DH-1279/microprocessor-capstone-design/03. 김가네 캡스톤 디자인/docs/2026-10-16_DH_AI_HAT_카메라_추론_및_쿨러_동작점검.md

# AI HAT+ 2·카메라 실제 추론 및 액티브 쿨러 동작 점검

- 작업일: 2026-10-16
- 담당: 김동환(DH)
- 대상: Raspberry Pi 5, AI HAT+ 2(Hailo-10H), Camera Module 3, 액티브 쿨러
- 작업 브랜치: `DH-1279/2026-10-16`
- 확인 근거: 사용자가 전달한 Pi 터미널 로그·실물 동작 확인, 공통 추론 코드 및 수정 후 개발 PC 검사 결과

**해수가 업로드한 18클래스 HEF 모델을 공통 `haptic_mvp` 코드로 실행하여, 실제 카메라 영상에서 탐지 이름·신뢰도·좌표가 출력되는 것을 확인했다. 액티브 쿨러는 10초 최대 출력 시험과 사용자 확인으로 회전 동작을 점검했다.**

이번 시험은 카메라와 HAT의 단독 추론이다. 손 인식, 음성 명령, 목표 선택, BLE 모터 제어를 연결한 전체 MVP 시험은 아직 수행하지 않았다.

## 1. 실행 환경과 모델

| 항목 | 확인 내용 |
|---|---|
| 운영체제·아키텍처 | Debian GNU/Linux 13 Trixie, `aarch64` |
| Pi Python | 3.13.5, 기존 `Raspi5_vision/.venv` 사용 |
| HailoRT CLI·펌웨어 | 5.1.1 |
| 장치 | AI HAT+ 2, `HAILO10H` |
| 카메라 | IMX708, Camera Module 3 |
| 카메라 출력 | 640×480. 로그의 libcamera 스트림 표기는 `BGR888` |
| 모델 입력 | RGB, UINT8, NHWC, 640×640×3 |
| 모델 출력 | FLOAT32, `HAILO NMS BY CLASS`, 18클래스 |
| HEF 내 후처리 설정 | score threshold 0.250, IoU threshold 0.70, 클래스당 최대 100박스 |
| 공통 코드의 점수 필터 | 기본 `score_threshold: 0.5` 적용 |
| 시험 도구 | [`tools/check_hailo_camera.py`](../Raspi5_vision/tools/check_hailo_camera.py) |

### 시험에 사용한 모델 출처

- 팀원 브랜치: `seawater0414/2026-10-14`
- 검토 기준 커밋: `d96d859621cf353c0c9aca11e521626319d2a93a`
- 저장소 내 모델: `03. 김가네 캡스톤 디자인/Raspi5_vision/KHS_object_detection/best_hailo_model/best.hef`
- Pi 시험용 모델: `/tmp/kimgane-khs-check/best.hef`
- Pi 시험용 라벨: `/tmp/kimgane-khs-check/labels.txt`
- 검토한 HEF의 SHA-256: `3e78431a361cb154617472d7ea133e428c17aecd23ea95e929e874206667e788`

라벨은 학습 때의 클래스 번호에 맞춰 다음 순서를 사용했다. 대소문자도 유지했다.

```text
bottle, cell phone, cup, handbag, keyboard, laptop,
mouse, remote, scissors, tie, Glasses, key,
Medicine, Tumbler, Pen, Wallet, watch, Wireless Earbud
```

`parse-hef`는 `HEF Compatible for: HAILO15H, HAILO10H`와 18클래스 NMS 출력을 표시했다. 이후 실제 장치에서 모델 로딩과 추론까지 성공했다. HEF에 기록된 컴파일 SDK 버전은 5.4.0이지만, 이번 파일은 설치된 HailoRT 5.1.1에서 실행됐다. 이 결과를 다른 HEF 파일의 호환성 보장으로 확대하지 않는다.

## 2. 실행 중 발생한 오류와 수정

| 발생한 문제 | 확인 내용·원인 | 조치와 결과 |
|---|---|---|
| `FileNotFoundError: .../labels.txt` | 라벨을 기록하려는 `/tmp/kimgane-khs-check` 폴더가 없었음. 폴더가 없어진 이유는 확정하지 않음 | 폴더를 생성하고 HEF·라벨을 다시 준비 |
| `AttributeError: 'Device' object has no attribute 'identify'` | 코드가 설치된 HailoRT Python API와 다른 호출 경로를 사용 | `physical.control.identify()`로 수정. 이후 모델 로딩 성공 |
| `ValueError: Expected normalized, ordered NMS coordinates` | 기존 검사는 모든 NMS 좌표가 0~1 안에 있어야 한다고 가정. Hailo YOLOv8 디코더는 경계 밖 좌표를 출력할 수 있음을 공식 구현에서 확인 | Hailo NMS 경로에서 경계 밖 좌표를 허용하고 원본 영상 범위로 잘라내도록 수정. 이후 152프레임 실행에서 재발 없음 |
| 기본 10프레임으로 관찰 시간이 짧음 | 물체를 카메라에 보여주며 확인하기에는 실행 시간이 짧았음 | `--frames 300`으로 늘리고 외부 제한을 `timeout 180s`로 설정 |

좌표 오류 당시의 원시 NMS 행은 확보하지 못했으므로, 정확히 어떤 값이 예외를 일으켰는지는 확정하지 않았다. 수정은 공식 디코더의 경계 처리 방식과 코드의 과도한 범위 제한을 근거로 진행했다.

수정 후에도 NaN·무한대, 뒤집힌 좌표, 잘못된 클래스 수·출력 형식은 오류로 처리한다. 영상과 겹치지 않거나 면적이 없는 박스는 제외한다. 좌표 복원 함수의 다른 호출 경로에는 기존의 엄격한 범위 검사를 유지했다.

### 반영한 코드

- `fef8cc6` — `fix: identify Hailo devices through Control API`
  - 장치 식별 API와 doctor 검사, 관련 테스트 및 설치 안내 수정.
- `d5d65fb` — `fix: clip Hailo edge detections to the source frame`
  - NMS 경계 좌표 복원 수정, 회귀 테스트 추가, 카메라·HAT 단독 시험 도구 추가.

실제 Pi 시험은 위 수정 사항이 있는 `DH-1279/2026-10-16` 브랜치를 받아 진행했다. 이 문서는 해당 브랜치가 `main`에 머지됐다는 기록은 아니다.

## 3. 카메라·HAT 실제 추론 결과

### 실행 명령

모델과 라벨을 준비하고 수정 브랜치를 받은 상태에서 다음 명령으로 실행했다.

```bash
cd "$HOME/Desktop/kimGA_raspi/microprocessor-capstone-design/03. 김가네 캡스톤 디자인/Raspi5_vision"
source .venv/bin/activate
timeout 180s python -u tools/check_hailo_camera.py --frames 300
```

PuTTY에서 실행했으며, 별도의 영상 창 없이 터미널에 탐지 결과를 출력했다. 시험 도구는 프레임마다 0.3초씩 대기한다.

### 로그 집계

| 항목 | 결과 |
|---|---:|
| 요청한 프레임 | 300 |
| 실제 출력된 프레임 | 152 |
| 첫 프레임 탐지 함수 처리 시간 | 57.2ms |
| 2~152프레임 평균 처리 시간 | 약 13.6ms |
| 2~152프레임 처리 시간 범위 | 13.2~14.0ms |
| 탐지 결과가 있는 프레임 | 91 |
| 탐지 결과가 없는 프레임 | 61 |
| 프레임 전체에서 출력한 탐지 항목 수 | 115 |
| 출력된 신뢰도 범위 | 0.50~0.82 |
| 종료 | 152프레임 후 사용자가 `Ctrl+C`로 중단 |
| 최종 실행의 Python 예외 | 없음 |

| 출력된 라벨 | 프레임 전체의 출력 횟수 |
|---|---:|
| `watch` | 17 |
| `cell phone` | 5 |
| `Glasses` | 45 |
| `mouse` | 4 |
| `keyboard` | 44 |

115개는 같은 물체를 여러 프레임에서 탐지한 항목을 포함한다. 서로 다른 실물 115개를 인식했다는 의미가 아니다. 또한 91/152는 정확도나 재현율이 아니다. 실제 화면의 정답과 비교하지 않았으므로 모델 성능 수치로 사용하지 않는다.

### 대표 출력

```text
모델 로딩 성공 | 입력 640×640 | 클래스 18개
프레임 11/300 | 추론 13.6ms | 탐지 2개
  watch | 신뢰도 0.67 | 좌표 (0.028, 0.054, 0.913, 0.208)
  cell phone | 신뢰도 0.56 | 좌표 (0.796, 0.129, 1.0, 0.857)
...
프레임 152/300 | 추론 13.5ms | 탐지 0개
^C
사용자 요청으로 점검을 중단했습니다.
```

출력 좌표는 원본 영상 기준의 정규화된 `(x1, y1, x2, y2)`다. 영상 가장자리를 넘어가는 박스는 0~1 범위로 잘리므로 `1.0` 같은 경계값이 나올 수 있다. 값이 출력된 사실만으로 실제 물체와 박스가 정확히 일치한다고 판단하지 않는다.

처리 시간은 `detector.detect(rgb)` 호출에 소요된 시간으로, 전처리·HAT 실행·결과 해석을 포함한다. 카메라 읽기, 터미널 출력, 프레임 사이 대기는 포함하지 않는다. 따라서 **약 13.6ms를 전체 시스템의 70FPS 이상 처리 성능이나 종단 간 응답 시간으로 해석하지 않는다.**

카메라 초기화 때 `Unsupported V4L2 pixel format Nc30`, `Nc12` 경고가 있었지만, 이어서 스트림 설정과 추론이 진행됐다. 이번 로그에서는 실행을 중단시킨 오류가 아니었다.

## 4. 액티브 쿨러 설치 및 시험

액티브 쿨러 설치 후 온도 설정과 회전 센서값을 확인했다.

```bash
grep -H . /sys/class/thermal/thermal_zone0/trip_point_*_temp
grep -H . /sys/class/hwmon/hwmon*/fan1_input 2>/dev/null
```

| 조회 항목 | 실제 출력 |
|---|---|
| `trip_point_0_temp` | 110000 |
| `trip_point_1_temp` | 50000 |
| `trip_point_2_temp` | 60000 |
| `trip_point_3_temp` | 67500 |
| `trip_point_4_temp` | 75000 |
| 팬 장치 이름 | `pwmfan` |
| 최초 회전수 출력 | 2623 RPM |
| 이후 모니터 화면 | CPU 49.6°C, 팬 2726 RPM |

`trip_point_0`의 110°C는 팬 시작 온도로 해석하지 않는다. 또한 센서값만으로 사용자가 보고한 “팬이 안 도는 것 같다”는 관찰을 해소했다고 판단하지 않고, 최대 출력 시험을 추가했다.

### 10초 최대 출력 시험

시험 스크립트는 PWM을 최대값으로 유지하며 매초 회전수를 출력하고, 종료 시 이전 PWM 값으로 복원하도록 실행했다. 실제 출력은 다음과 같다.

```text
1초  7867 RPM
2초  8736 RPM
3초  8849 RPM
4초  8865 RPM
5초  8891 RPM
6초  8925 RPM
7초  8965 RPM
8초  9003 RPM
9초  9038 RPM
10초 9077 RPM
테스트 전 PWM 값(0)으로 복구했습니다.
```

사용자가 최대 출력 때 팬 소리·바람이 강해졌음을 확인했다. 이 결과로 팬 회전과 속도 변경 동작을 확인했다. 이번 추론 시험 중의 CPU·Hailo 온도 로그는 수집하지 않았으므로, 쿨러 설치 전후의 냉각 성능이나 장시간 추론 시 온도 안정성은 아직 비교하지 않았다.

## 5. 개발 PC에서 수행한 코드 검사

최종 좌표 수정 후 개발 PC에서 수행한 검사 결과다. 실제 Pi 하드웨어 시험과 별도로 구분한다.

| 검사 | 결과 | 확인 범위 |
|---|---|---|
| pytest | 946 passed, 47 subtests passed | 공통 로직 및 SDK 대역을 이용한 회귀 검사 |
| 시뮬레이션 | 6개 시나리오 PASS | 손·목표 유실, 오래된 프레임, 다중 물체, 통신 유실 등 제어 시나리오 |
| Ruff | 통과 | 정적 코드 검사 |
| Mypy | 통과 | 타입 검사 |
| 시험 도구 CLI | 도움말·모델 누락 시 초기 오류 확인 | 실행 옵션과 파일 준비 조건 |

이번에 추가한 테스트는 장치 식별 API와 자원 해제, 경계 밖 NMS 좌표, 원본 영상 좌표 복원, 잘못된 좌표 거부를 다뤘다. 이러한 검사가 실제 카메라 인식 정확도나 물리적 모터 동작을 검증한 것은 아니다.

## 6. 현재 완료 상태와 다음 작업

- [x] AI HAT+ 2 장치 식별 및 HEF 출력 계약 확인.
- [x] 해수의 18클래스 HEF를 실제 HAT에 로딩.
- [x] 실제 카메라 입력으로 물체 이름·신뢰도·좌표 출력.
- [x] API 호출 오류 수정 후 실제 실행 확인.
- [x] NMS 좌표 경계 처리 수정 후 152프레임 실행 확인.
- [x] 액티브 쿨러 최대 출력 시험 및 사용자 동작 확인.
- [ ] 박스·라벨을 영상에 표시하여 실제 물체와 비교.
- [ ] 고정된 카메라 위치에서 대상 물체별 오탐·미탐·가림·거리 변화 기록.
- [ ] 더 긴 연속 추론과 CPU·Hailo 온도·전체 처리 속도 측정.
- [ ] MediaPipe 손 모델 준비 및 같은 영상 프레임에서 손·물체 좌표 확인.
- [ ] 18클래스 라벨과 한국어 음성 명령·목표 목록의 매핑 정리.
- [ ] 목표 선택·손 방향 계산·BLE·모터 출력 연결.

우선 다음 시험은 **PC 브라우저 등에서 박스와 이름이 표시된 영상을 보며 탐지를 확인하는 것**이 적절하다. 현재 텍스트 로그는 추론 경로의 동작을 보여주지만, 올바른 물체를 올바른 위치에서 잡는지는 보여주지 못한다. 영상 확인 방식은 아직 구현·시험하지 않았다.

전체 MVP 설정에는 별도 확인이 필요하다. 이번 시험은 임시 HEF·18라벨을 시험 도구에만 지정했으며 기본 모델 파일이나 공통 설정을 교체하지 않았다. 기존 목표 목록의 `book`은 이번 18클래스에 없으므로 통합 전에 목표 목록도 함께 조정해야 한다.

해수의 **모델 파일 실행 성공**과 해수 브랜치의 **GStreamer 실행 코드 전체 검증**은 구분한다. 이번에는 공통 `HailoDetector`를 사용했으므로 팀원 코드의 API·콜백·라벨 형식 문제를 해결했다거나, 팀원 브랜치 전체가 머지 가능한 상태라고 판단하지 않는다. 기존 수정 요청은 [팀원 코드 리뷰 문서](2026-10-15_DH_팀원코드리뷰_및_실행점검.md)와 함께 확인한다.

## 7. 서멀 모니터 개선

액티브 쿨러 설치에 맞춰 [`thermal_monitor.py`](../Raspi5_vision/tools/thermal_monitor.py)를 개선했다.

- CPU 온도 옆에 팬 상태와 RPM 표시. 좁은 터미널에서는 팬을 별도 행으로 표시.
- `RUNNING`, `STOPPED`, PWM 출력 중 회전수 0인 `CHECK`, 조회 실패 `N/A`를 구분.
- 팬 장치 이름으로 센서를 찾으므로 `hwmon` 번호가 바뀌어도 조회 가능.
- 화면 크기에 맞춰 각 행을 고정 위치에 갱신. 화면 아래쪽·오른쪽 끝 출력과 새 줄 누적을 피하도록 변경.
- 별도 터미널 화면에서 실행하고 종료 시 원래 화면·커서를 복원.
- 팬 제어 파일에 값을 쓰지 않으며, 기존 자동 팬 제어를 유지.
- 터미널이 아닌 출력은 기본 한 번만 표시. 반복 파일 기록은 `--log`로 명시.

Pi에서 새 코드를 받은 뒤, 별도 PuTTY 터미널에서 실행할 명령은 다음과 같다. `watch`로 감싸지 않는다.

```bash
cd "$HOME/Desktop/kimGA_raspi/microprocessor-capstone-design/03. 김가네 캡스톤 디자인/Raspi5_vision"
python3 tools/thermal_monitor.py --screen
```

화면 예시의 숫자는 가상값이다. 실제 센서 결과와 혼동하지 않도록 `--demo` 실행에는 `SIMULATED`를 표시한다.

```text
CPU    46.5 °C  █████████░░░░░░░░░░░  |  FAN RUNNING 2726 RPM
HAILO  54.2 °C  ███████████░░░░░░░░░
```

개발 PC에서 관련 테스트 **21개와 subtest 23개**, Ruff·Mypy 검사를 통과했다. 팬 장치 탐색, 센서 실패·정지 구분, 화면 크기 변경·한글 폭 처리, 갱신 시 새 줄 미출력, 예외·Ctrl+C 종료 복원을 확인했다. **개선한 모니터의 실제 Pi·PuTTY 실행은 아직 미확인**이며, 앞 절의 실제 팬 시험과 구분한다. 센서 조회 근거는 [Linux pwm-fan 문서](https://docs.kernel.org/hwmon/pwm-fan.html)를 참고한다.

## 8. 재실행 시 주의 사항과 관련 자료

`/tmp/kimgane-khs-check`의 모델·라벨은 임시 파일이다. 재부팅 등으로 사라지면 다시 준비해야 한다. 시험 도구는 파일이 없거나 비어 있으면 시작 전에 오류를 내며, 모델을 자동 다운로드하지 않는다. 다른 위치의 준비된 파일은 `--model`, `--labels`로 지정할 수 있다.

300프레임과 180초는 실행 제한이다. 이번에는 사용자가 먼저 종료했으므로 300프레임 완주나 180초 연속 동작을 확인한 것으로 기록하지 않는다.

- [공통 비전 설치·실행 안내](../Raspi5_vision/VISION_SETUP.md)
- [카메라·HAT 단독 시험 도구](../Raspi5_vision/tools/check_hailo_camera.py)
- [USB 마이크·스피커 기본 시험 기록 — 2026-10-15](2026-10-15_DH_USB_마이크_스피커_동작점검.md)
- [HailoRT 5.1.1 공식 Python API](https://github.com/hailo-ai/hailort/blob/v5.1.1/hailort/libhailort/bindings/python/platform/hailo_platform/pyhailort/pyhailort.py): 장치 식별 호출 경로 확인 근거.
- [HailoRT 5.1.1 공식 YOLOv8 후처리 구현](https://github.com/hailo-ai/hailort/blob/v5.1.1/hailort/libhailort/src/net_flow/ops/yolov8_post_process.cpp): 경계 밖 좌표가 생성될 수 있는 디코딩 방식 확인 근거.
