DH-1279/microprocessor-capstone-design/03. 김가네 캡스톤 디자인/docs/2026-09-29_역할분담_회의록.md

# 역할 분담 회의록

- 회의일: 2026-09-29
- 상태: 세부 역할 분담 확정
- 작성 근거: 회의 논의 내용과 사전 공유된 파트 구분안

## 1. 파트 구분

사전에 공유된 파트는 다음 네 가지다.

| 번호 | 파트 | 내용 |
|---|---|---|
| 1 | 핸드 인식 | MediaPipe 기반 손 인식 |
| 2 | 물체 인식 | YOLO + COCO 데이터셋 기반 인식. Kaggle·HuggingFace 등에서 데이터셋 추가 조사. 라즈베리파이에서 구동 가능한 경량 모델 선정 |
| 3 | 회로 | PCB 및 ESP32 메모리 최적화 |
| 4 | 프론트 | 라즈베리파이의 현재 손 인식 상태와 인식 중인 물체 표시, TTS·STT 구현 |

## 2. 역할 분담 결과

| 담당 | 파트 |
|---|---|
| 김민주 | 1. 핸드 인식 + 4. 프론트·TTS·STT |
| 김해수 | 2. 물체 인식 |
| 김동환 | 3. 회로 PCB + ESP32 메모리 최적화 |

## 3. 논의 내용

### 1번과 4번을 하나로 묶기로 결정

프론트 파트의 규모가 크지 않을 것으로 보여, 핸드 인식과 함께 한 명이 담당하는 방향을 논의했다. 두 작업 모두 손 인식 결과를 다루는 만큼 묶어서 진행하는 편이 낫다고 판단해 하나로 묶기로 결정했다.

## 4. 다음 일정

- 각자 담당 파트에 대해 MVP, 사용할 모델과 기술, 선택 근거, 구현 구조, 검증 방법, 추가로 필요한 부품을 조사·정리한다.
- 해결하지 못한 문제도 함께 기록하고, 조사한 내용과 실제로 검증한 결과는 구분해 작성한다.
- 최신 main을 받아 `본인 GitHub 아이디/작업 날짜` 형식으로 작업 브랜치를 생성한다.
- 조사 문서는 `docs` 폴더에 `날짜_이니셜_맡은파트.md` 형식으로 작성한다.
- 기한: 2026-09-30(수) 12시
- 작성 후 본인 브랜치에 commit·push하고, main을 대상으로 Pull Request를 생성해 링크를 톡방에 공유한다.
- 김동환 팀장이 각 PR을 검토한 후 순서대로 merge한다. 수정이 필요하면 기존 작업 브랜치에 다시 push한다.
