DH-1279/microprocessor-capstone-design/03. 김가네 캡스톤 디자인/docs/2026-09-14_프로젝트_착수_기준.md

# 비전 기반 햅틱 글러브 프로젝트 착수 기준

- 기준일: 2026-09-14
- 상태: 사용자에 의해 주제 및 신청서 기준 개발 방향 확정, 프로젝트 착수
- 근거: 사용자의 확정 의사, `01. 신청서 및 결과보고서 작성 항목_비전햅틱.hwp`, 후속 확정 부품표 `김가네 부품 정리.xlsx`
- 원본 위치: `(붙임2) 2026학년도 2학기 IC-PBL 캡스톤디자인 안내/01. 신청서 및 결과보고서 작성 항목_비전햅틱.hwp`
- 2026-09-15 폴더 정리 후 원본과 부품표는 저장소 루트의 `00. 캡스톤 관련 문서/` 아래에서 로컬로 관리한다.

이 문서는 확정 신청서의 내용과 착수를 위한 제안을 구분해 기록한다. 신청서 양식의 제출·작성 안내는 행정 참고사항이며, 이번 작업의 제출 또는 결과보고서 작성 요청으로 해석하지 않는다. 원본 신청서는 수정하지 않았다.

## 최신 부품 구성 — 사용자 후속 확정

### 부품표 확인 이후 수정 사항 (최우선)

- 카메라는 **1대 사용 방향**으로 수정한다. 엑셀에 적힌 와이드·스탠다드 두 종류 중 사용할 모델은 미정이며, 아래 표는 원본 부품표 기록이다.
- 장갑은 **손가락별 모터 1개, 장갑당 총 5개**로 사용자가 확정했다. 회로도 채널명은 TH·IN·MI·RI·PI이다. 아래 신청서의 4모터 구성은 이전 계획이다.
- 장갑 PCB는 사용자가 설계한다. 현재 공유된 것은 회로도 이미지이며, 회로 원본·실제 PCB 배치·배선은 아직 검토하지 않았다.
- 모터 5개의 역할에 맞춰 방향·근접도 진동 패턴을 정한다. 카메라 수량 변경으로 기존 부품표 합계도 최종 구매 합계로 사용하지 않는다.

사용자가 `김가네 부품 정리.xlsx`의 부품으로 진행한다고 밝혔다. 아래는 당시 부품표의 기록이며, 상단 후속 수정 사항이 우선한다. 색상은 시스템 구분이며 구매 상태나 우선순위를 뜻하지 않는다. 실제 색상은 Sheet1의 A열 항목 번호 셀에 적용되어 있다.

| 색상 / 구분 | 원본 범위 | 부품 | 수량 |
|---|---|---|---:|
| 파란색 / 메인 카메라 쪽 | A2:E4 | Raspberry Pi AI HAT+ 2 | 1 |
| 파란색 / 메인 카메라 쪽 | A2:E4 | Raspberry Pi Camera Module 3 Wide | 1 |
| 파란색 / 메인 카메라 쪽 | A2:E4 | Raspberry Pi Camera Module 3 Standard | 1 |
| 초록색 / 장갑 디바이스 | A12:E17 | ESP32-C3 SuperMini 개발보드 블랙 | 3 |
| 초록색 / 장갑 디바이스 | A12:E17 | PN-VM102 코인형 진동 모터 (10mm × 2mm) | 10 |
| 초록색 / 장갑 디바이스 | A12:E17 | AO3400A MOSFET | 10 |
| 초록색 / 장갑 디바이스 | A12:E17 | MPU-6050 6축 자이로·가속도 센서 모듈 GY-521 | 3 |
| 초록색 / 장갑 디바이스 | A12:E17 | 3.7V 1000mAh KC인증 리튬폴리머 배터리 | 2 |
| 초록색 / 장갑 디바이스 | A12:E17 | MP103450P (3.7V 2000mAh) C5264RR 배터리 | 2 |

파란색 전체 구역은 A2:A11, 초록색 전체 구역은 A12:A21이다. 제품명이 없는 행은 추가 기입 공간으로 두며, 부품을 임의로 채우지 않는다. 원본 엑셀은 수정하지 않았다.

부품표에는 와이드 1대 + 스탠다드 1대가 기재되어 있으나, 이후 사용자는 카메라 1대 사용 방향으로 수정했다. MPU-6050은 선정 부품으로 기록한다. 부품표의 전체 수량과 글러브 한 대에 탑재할 수량은 구분한다. 모터는 후속 결정에 따라 글러브당 5개이며, 보드·모터 등의 예비품 배분과 배터리 용량별 사용 목적은 아직 명시되지 않았다.

가격 열 D를 개당 가격으로 해석해 수량 C를 곱하면 메인 카메라 쪽 414,920원, 장갑 쪽 128,920원, 합계 543,840원이다. 원본 제목은 '가격'이므로 단가라는 해석은 가정이며, 배송비·부가세 포함 여부와 빈 행에 들어갈 추가 부품 비용도 확정하지 않는다. 최신 목록의 금액을 이전 신청서 예산과 중복 합산하지 않는다.

현재 목록에 Raspberry Pi 본체, 전원 어댑터·쿨러, 배터리 충전·보호회로 등은 기재되어 있지 않다. 보유품 또는 추후 추가품인지 구분할 필요가 있다. 카메라별 설치 위치와 역할, MPU-6050 데이터 활용 방식, 배터리 배분은 다음 설계 단계에서 정한다. 제품 호환성과 실제 동작은 아직 검증하지 않았다.

## 1. 확정 신청서 기준

| 항목 | 내용 |
|---|---|
| 과제명 | 시각장애인 및 저시력자의 실내 물건 탐색을 위한 비전 기반 햅틱 글러브 시스템 개발 |
| 팀명 | 김가네 |
| 과제유형 / 분야 | 기업연계형 / 디스플레이·반도체계열 |
| 참여기업 | 태영소프트 |
| 사용 환경 | 고정형 탑뷰 카메라가 관찰하는 책상 위 |
| 영상 처리 | 신청서 본문상 PC에서 YOLO 기반 목표 물체 탐지와 손 관절 인식 |
| 방향 안내 | 물체와 손의 상대 위치를 계산하고 손의 회전·뒤집힘에 따라 진동 위치 조정 |
| 글러브 | ESP32와 진동 모터 4개 |
| 근접도 안내 | 물체에 가까워질수록 진동 간격 감소 |
| 통신 | BLE 또는 Wi-Fi 중 선정 필요 |
| 하드웨어 결과물 | 제어·전원 회로를 통합한 PCB 및 글러브 시제품 |
| 평가 항목 | 물체 탐색 성공률, 탐색 소요 시간, 방향 안내 정확도 |
| 예산 총괄 | 재료비 730,000원 + 회의비 150,000원 = 880,000원 |

태영소프트의 신청서상 역할은 아이디어·구현 방향 자문, 설치·착용 편의성 검토, 범위 및 평가 항목 검토, 사용자 영상 수집·저장 범위와 개인정보 보호 방안에 대한 조언이다. 실제 참여 시점과 방식은 협의 예정이다.

Whisper 기반 음성 요청 연동이 기재되어 있으며, LLM·VLM을 이용한 상황별 요청은 확장 방향이다. 음성 기능의 구현 시점과 초기 시연 포함 여부는 별도로 정한다.

## 2. 이전 신청서 부품 예산 기록

아래 금액과 제품명은 이전 신청서 기재값이다. 최신 선정 부품은 위의 '최신 부품 구성'을 따른다. 현재 판매가격이나 호환성을 검증한 구매 명세가 아니다.

| 항목 | 기재 예산 |
|---|---:|
| Raspberry Pi AI HAT+ 2 | 350,000~400,000원 |
| Raspberry Pi Camera Module 3 Wide × 2 | 70,000원 |
| Raspberry Pi 5 공식 27W 어댑터 | 20,000원 |
| Raspberry Pi 5 Active Cooler | 10,000원 |
| ESP32-C3 SuperMini × 2~3 | 20,000~25,000원 |
| 햅틱 모터 PN-VM102 × 10 | 45,000원 |
| AO3400A·저항·다이오드·캐패시터 | 15,000~20,000원 |
| Li-Po 배터리·충전/보호회로 | 30,000~40,000원 |
| 커스텀 PCB 제작 및 재제작 여유 | 50,000~70,000원 |
| 장갑·밴드·모터 고정부 | 20,000~30,000원 |
| 3D 프린팅·카메라 거치 구조 | 30,000~40,000원 |
| 기타 예비부품 | 30,000~40,000원 |
| **세부 항목 단순 합계** | **790,000~910,000원** |

세부 합계는 재료비 총괄 730,000원보다 60,000~180,000원 높다. 보유품 사용 여부와 수량·금액을 확인해 예산표를 맞춰야 한다. Raspberry Pi 5 본체는 별도 항목으로 보이지 않으므로 보유 여부 또는 다른 항목에 포함되었는지도 확인한다.

## 3. 착수 전에 정리할 설계 사항

1. **연산 장치:** 본문은 PC이고 예산은 Raspberry Pi용 장비를 포함한다. PC를 개발·시험용으로 쓰고 Raspberry Pi를 최종 장치로 쓸지, 최종 구성도 PC인지 확정한다. 모델 실행 가능 여부와 성능은 장치 선정 과정에서 확인한다.
2. **카메라 1대 구성:** 와이드·스탠다드 중 사용할 모델, 설치 높이와 촬영 범위를 정한다.
3. **탐색 대상과 도달 기준:** 초기 대상, 손 위치의 기준점, 허용 오차를 정한다. 영상에서 손과 물체가 겹치는 것과 실제로 집을 수 있는 위치에 도달한 것을 평가에서 구분한다.
4. **글러브 구조:** 손가락별 모터 5개의 구체적인 부착 위치, 회전·뒤집힘에 따른 방향 대응 규칙과 MPU-6050 활용 방식을 시험으로 정한다.
5. **통신과 추적 실패 처리:** BLE/Wi-Fi를 선정하고, 추적이 끊기거나 명령이 오래 갱신되지 않을 때 진동을 중단하는 조건을 정의한다.
6. **진행 관리:** 팀원별 담당, 보유 장비, 실제 구매 가능 예산, 기업 자문 일정을 확인한다.

## 4. 첫 개발 단계 제안

아래 순서와 완료 조건은 착수 제안이며 팀이 확정한 일정이나 성능 수치가 아니다.

**첫 시연 목표:** 제한된 책상 환경에서 목표 물체 하나를 선택하면 손과 물체의 상대 위치를 계산하고, 글러브 진동으로 손의 이동 방향을 알려주는 과정을 연결한다.

| 순서 | 작업 | 완료 시 확인할 결과 |
|---|---|---|
| 1 | 연산 장치·카메라 구성과 초기 대상 확정 | 시스템 구성도, 보유품 목록, 조정된 부품 예산 |
| 2 | 카메라 영상에서 목표 물체와 손 추적 | 위치를 표시한 시험 영상, 장갑 착용·회전·뒤집힘 시 인식 결과 |
| 3 | ESP32에서 손가락별 모터 5개 개별 구동 | 각 모터의 독립 제어와 착용 상태의 진동 구분 결과 |
| 4 | 상대 위치 계산과 무선 진동 명령 연결 | 손을 움직이면 방향·근접도에 따라 진동이 바뀌는 통합 시연 |
| 5 | 회전·뒤집힘, 가림, 통신 단절 시험 | 방향 대응 및 안내 중단·재개 결과, 실패 사례 기록 |
| 6 | 회로·착용 구조 검증 후 PCB 설계 | 구동·전원 측정 결과와 PCB 설계 자료 |

첫 실험부터 탐색 대상, 손의 시작 위치, 조명·가림 조건, 성공/실패, 소요 시간, 오안내 사례를 같은 형식으로 기록한다. 성공률과 방향 안내 정확도는 계산에 사용할 성공 판정과 전체 시도 수를 먼저 정의한다.

## 5. 이전 기록과의 관계

2026-09-09 기록은 당시의 주제안과 검토 이력으로 유지한다. 해당 기록의 참여기업·예산 미기재 상태는 이번 신청서로 갱신되었다. 이후 부품표에서 IMU인 MPU-6050이 선정되었다. 이전에 논의한 ToF, RGB-D 및 특정 소프트웨어 프레임워크는 채택이 확정된 것으로 보지 않는다.
