DH-1279/microprocessor-capstone-design/03. 김가네 캡스톤 디자인/docs/2026-09-30_KHS_객체인식.md

객체 인식

## 1. MVP
실시간 객체 인식 : 책상위의 객체를 카메라로 영상을 입력받아 실시간으로 탐지한다.

좌표 추출 : 탐지된 객체의 바운딩 박스 중심 좌표와 이름 데이터를 도출한다.

## 2. 사용할 모델과 기술
사용 AI 모델 : YOLOv8n

데이터셋(추가조사) : MS COCO 데이터셋, Kaggle, Roboflow Universe

기술 스택(추가조사) : Python, OpenCV

## 3. 선택 근거
YOLOv8n : 엣지 디바이스 환경에서 연산량 대비 정확도 우수

## 4. 구현 구조
영상 캡처 : 라즈베리 파이 카메라 모듈에서 실시간 프레임 캡처

전처리(OpenCV) : 불필요한 배경을 제거하는 관심 영역 설정 및 해상도 리사이징

NPU 추론 : YOLOv8n 모델을 통한 객체 식별 및 바운딩 박스 좌표 도출

좌표 연산 : 도출된 바운딩 박스의 좌상단/우하단 좌표를 활용해 물체의 중심점 계산

데이터 송신 :

## 5. 추가로 필요한 부품
카메라 거치 구조물

## 6. 검증 방법(계획)
성능 지표 : 추론 소요 시간을 측정

인식 정확도 : 평가용 데이터셋 또는 실제 환경 에서 잘 인식 되는지 테스트

## YOLO 테스트
기본 YOLOv8n,YOLOv10n둘 다  지갑, 캔, 무선 이어폰, 빗같은건 인식 못함
음료 병, 키보드, 사람, 노트북등은 잘 인식

전자기기 (6개): 휴대폰, 리모컨, 마우스, 키보드, TV, 노트북

주방/식기 (7개): 병, 컵, 포크, 나이프, 숟가락, 그릇, 와인잔

실내 소품 (7개): 책, 가위, 시계, 칫솔, 꽃병, 테디베어, 헤어드라이어

가방/액세서리 (5개): 배낭, 우산, 핸드백, 넥타이, 여행가방

가구 (6개): 의자, 소파, 화분, 침대, 식탁, 화장실

가전제품 (5개): 전자레인지, 오븐, 토스터, 싱크대, 냉장고

사람 (1개): 사람

이동 수단 (8개): 자전거, 자동차, 오토바이, 비행기, 버스, 기차, 트럭, 보트

도로/야외 (5개): 신호등, 소화전, 정지 표지판, 주차 미터기, 벤치

동물 (10개): 새, 고양이, 강아지, 말, 양, 소, 코끼리, 곰, 얼룩말, 기린

스포츠 용품 (10개): 프리스비, 스키, 스노보드, 스포츠 공, 연, 야구 방망이, 야구 글러브, 스케이트보드, 서프보드, 테니스 라켓

음식 (10개): 바나나, 사과, 샌드위치, 오렌지, 브로콜리, 당근, 핫도그, 피자, 도넛, 케이크
80개의 객체만 인식
그래서 시각장애인 또는 저시력자들에게 필수적으로 필요한 지갑, 약통, 열쇠 등과 같은 물건들도 인식 가능하도록 하고 불필요한 객체(기린, 코끼리, 신호등, 표지판 등등)는 인식 안하도록 학습 필요
이 학습을 위한 데이터셋 조사
기존 ms coco 데이터셋에서 기린, 코끼리, 비행기, 기차, 정지 표지판 등 실내 환경에서는 등장하지 않을 불필요한 항목을 제외한 데이터셋 구축(roboflow에서 coco 데이터셋(https://universe.roboflow.com/microsoft/coco) + 그 외에 추가로 학습 필요한 데이터셋)

약통 :  https://universe.roboflow.com/project-eqhlm/medicine-yald2/browse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
        https://universe.roboflow.com/teknofest-r4zmp/medicine-d7ttn/browse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
        https://universe.roboflow.com/sp2-w9mrj/medicine-grin8/browse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

열쇠 :  https://universe.roboflow.com/tankyuu-9k0dq/key-nd3sh/browse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

지갑 :  https://universe.roboflow.com/loganqin/wallet-vrjpl/browse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

스마트 워치(보류) : https://universe.roboflow.com/mrs-workspace-gtafy/smart-watch-2dmge/browse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

이어폰(보류) : https://universe.roboflow.com/nachu/wireless-earbud-detector (버즈)
                https://universe.roboflow.com/saakshi-saigaonkar/earphones-mb17q/browse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  (유선이어폰)
                https://universe.roboflow.com/javier-n5kep/headphone-t8jet/browse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 (헤드폰)

펜 : https://universe.roboflow.com/pancil/pen-pzeet/browse?queryText=&pageSize=100&startingIndex=0&browseQuery=true

빗 : https://universe.roboflow.com/devansh-kaushal-s-workspace/comb-ib8tf
