DH-1279/microprocessor-capstone-design/03. 김가네 캡스톤 디자인/docs/2026-09-05_캡스톤_주제_아이디어_정리.md

# 캡스톤디자인 주제 아이디어 정리

- 정리일: 2026-09-05
- 목적: 팀원별 캡스톤디자인 주제 아이디어 기록

## 1. 김민주

### 1) BLE 사용자 인증 기반 전기차 충전기 무단 분리 방지·알림 장치

- 전기차 PLC 충전기를 충전 중 다른 사람이 임의로 분리하는 상황을 방지한다.
- BLE를 이용해 사용자를 인증한 후 충전 커넥터를 분리할 수 있도록 한다.
- 인증되지 않은 사람이 충전기를 분리하거나 분리를 시도하면 사용자에게 알림을 전송한다.

### 2) 센서 기반 공용 전동킥보드 헬멧 착용 여부 확인 시스템

- 공용 전동킥보드 이용자가 헬멧을 착용했는지 센서로 확인한다.
- 헬멧 미착용 상태를 감지하면 이용자에게 경고하거나 주행 제한 신호를 제공한다.

### 3) 유모차·휠체어 경사면 미끄러짐 방지 자동 브레이크

- 유모차 또는 휠체어가 경사면에서 의도치 않게 미끄러지는 상황을 감지한다.
- 경사와 비정상 이동이 확인되면 자동으로 브레이크를 작동한다.

## 2. 김해수

### 1) 거주자 우선주차구역 무단주차 감지 및 신고 지원 시스템

- 거주자 우선주차구역에 등록되지 않은 차량이 주차하는 상황을 감지한다.
- 연락처를 남기지 않고 장시간 자리를 비운 차량을 카메라로 확인한다.
- 무단주차가 확인되면 관할 기관에 신고할 수 있도록 차량 정보와 현장 정보를 제공한다.

### 2) 이동형 카메라 기반 도서관 좌석 및 짐 방치 관리 시스템

- 소형 이동형 카메라가 도서관 책상 사이를 이동하며 좌석 상태를 확인한다.
- 의자에 사람이 앉아 있는지, 사람 없이 물건만 놓여 있는지를 구분한다.
- 물건만 놓인 상태가 일정 시간 지속되면 경고한다.
- 현재 사용할 수 있는 좌석 수를 집계하여 알려준다.

### 3) 캠핑장 지속 소음 감지 및 원격 경고 시스템

- 캠핑장에서 발생하는 고성이나 지속적인 소음을 감지한다.
- 단순히 순간 음량만 측정하지 않고 소음이 몇 분 동안 지속되는지도 함께 판단한다.
- 기준 이상의 소음이 일정 시간 계속되면 원격으로 관리자에게 알림을 전송한다.
- 해당 이용자 또는 구역에 경고 메시지를 전달한다.

## 3. 김동환

### 1) 객체 인식 기반 책상 상태표시 및 물건 위치 안내 시스템

- 카메라로 책상 위 상태와 각각의 물건을 인식한다.
- 사용자가 특정 물건을 찾으면 해당 물건의 위치를 확인한다.
- 레이저 포인터가 물건이 놓인 위치를 비춰 사용자가 쉽게 찾도록 안내한다.

### 2) Wi-Fi 신호 기반 벽 뒤 사람 감지 및 지속 추적 시스템

- Wi-Fi 신호 변화를 이용해 벽 뒤에 있는 사람의 존재와 움직임을 감지한다.
- 감지된 사람의 위치 또는 이동 상태를 지속해서 추적한다.

### 3) 비전 기반 모기 탐지 및 레이저 요격 시스템

- 카메라 영상으로 모기를 탐지하고 이동 경로를 추적한다.
- 탐지한 모기의 위치를 기준으로 레이저를 조준하여 요격한다.

### 4) 포트홀·블랙아이스 도로 표면 인식 및 GPS 위험지도 시스템

- 카메라 영상으로 포트홀과 블랙아이스 등 도로 표면의 위험 요소를 인식한다.
- 위험 요소가 감지된 위치를 GPS 좌표와 연결한다.
- 지도에 플래그를 표시하여 위험구간을 확인할 수 있도록 한다.
