DH-1279/microprocessor-capstone-design/03. 김가네 캡스톤 디자인/docs/images/2026-10-13_Object_Detection/Object Detection2.png

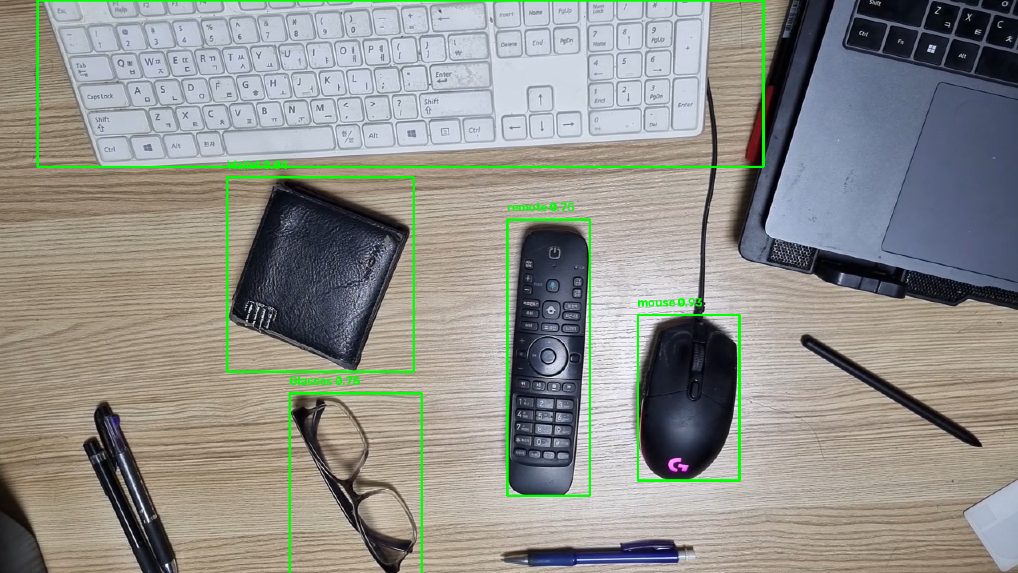
03. 김가네 캡스톤 디자인/docs/images/2026-10-13_Object_Detection/Object Detection2.png
