DH-1279/microprocessor-capstone-design/(commit log)

2026-09-15 docs: record ESP32-C3 bring-up and organize project files
2026-09-17 feat: add Raspberry Pi to ESP32 BLE LED test
2026-09-17 docs: record successful BLE LED hardware test and Pi setup
2026-09-18 docs: plan on-device Raspberry Pi vision and voice MVP
2026-09-19 feat: implement on-device vision voice and haptic MVP
2026-09-19 docs: record Raspberry Pi simulation and dependency setup
2026-09-24 docs: record glove PCB review and GPIO assignments
2026-09-29 docs: 역할 분담 회의록 작성
2026-09-30 docs: KHS 객체인식 파트 조사 문서 업로드
2026-10-02 docs: 객체인식 파트 데이터셋 조사
2026-10-05 docs: record glove PCB order and battery power plan
2026-10-07 docs: add user research and accessible UX flow prototype
2026-10-13 docs: 10/13 KHS 객체 인식 파트 테스트 코드 업로드
2026-10-14 yolo hef파일 업로드
2026-10-14 feat: add PCB bringup checks and October 14 repair record
2026-10-14 docs: 임시 저장
2026-10-14 docs: 라즈베리 파이 환경 욜로 구동 코드 추가
2026-10-16 fix: identify Hailo devices through Control API
2026-10-16 fix: clip Hailo edge detections to the source frame
2026-10-16 feat: show active fan RPM in a fixed thermal dashboard
2026-10-17 feat: add desktop preview to the Hailo camera check
2026-10-17 docs: hef 업데이트
2026-10-17 fix: keep camera preview running after invalid detections
2026-10-17 feat: add full sensor field of view to camera preview
2026-10-19 docs: detector 수정
2026-10-19 docs: detector 수정2
2026-10-19 docs: 03. 김가네 캡스톤 디자인 파일 이름 03.김가네_캡스톤_디자인 으로 변경
2026-10-19 docs: detector.py 수정
2026-10-19 docs: detector2.py 수정
2026-10-22 detector.py 수정
2026-10-23 feat: detect palm orientation and fingertips from the camera
2026-10-23 test: add palm orientation and fingertip tests
2026-10-23 docs: 작업 내용 업데이트 및 저장
2026-10-26 docs: detector3.py_KHS_KMJ_파트통합코드.md 업로드
2026-10-27 docs: 변경사항 저장
2026-10-27 라즈베리파이 브랜치 업로드
2026-10-27 feat: add ESP32 BLE rate and direction haptic modes
2026-10-28 feat: add independent Pi BLE v2 sender with terminal mode switching
2026-10-28 폴더 이름 수정
2026-10-28 fix: align BLE connection deadlines and report startup stages
2026-10-28 fix: tolerate delayed BLE acknowledgements without extending motor TTL
2026-10-28 feat: add five-finger rate guidance and maximum arrival double tap
2026-10-28 docs: record ESP32-C3 build and arrival verification results
2026-10-29 docs: use tested 75px 8-frame desktop launch command
2026-10-31 모델 hef 파일 변경
2026-10-31 docs : 모델 변경
2026-10-31 docs : 타겟 매핑 수정
